ProtoProtonas/SmartBuoy/README.md

# SmartBuoy
Repository for a smart buoy which can navigate to a destination on water and then come back.
