ProtoProtonas/SmartBuoy/Hardware/PCBs/GPSBoard/GPSBoard/GPSBoard_BOM.xlsx

Source: | C:\Users\Augustas\Desktop\shrot\projektukai\ESP32buoy\git\SmartBuoy\Hardware\PCBs\GPSBoard\GPSBoard\GPSBoard.kicad_sch
Date: | 2022-12-19 19:59
Tool: | Eeschema (6.0.9)
Generator: | C:\Program Files\KiCad\6.0\bin\scripting\plugins/bom_csv_grouped_by_value_with_fp.py
Component Count: | 19
Ref | Qnty | Value | Cmp name | Footprint | Description | Vendor
C1 , | 1 | 10u | C | Capacitor_SMD:C_1206_3216Metric_Pad1.33x1.80mm_HandSolder | Unpolarized capacitor | https://eu.mouser.com/ProductDetail/KYOCERA-AVX/1206DD106MAT2A?qs=lhAPX%252BE7qEaaGz%2FHFoBa1A%3D%3D
C2 , | 1 | <12pF | C_Feedthrough | YFF18AC0G475MT0Y0E:YFF18AC | Feedthrough capacitor | https://eu.mouser.com/ProductDetail/TDK/YFF18AC0G475MT0Y0E?qs=DRkmTr78QAR1NERkh6ttFw%3D%3D
D1 , | 1 | ESD9B3.3ST5G | ESD9B3.3ST5G | Diode_SMD:D_SOD-923 | ESD protection diode, 3.3Vrwm, SOD-923 | https://eu.mouser.com/ProductDetail/onsemi/ESD9B3.3ST5G?qs=yU2N9dt%252BrfmXrPf3vhgUEA%3D%3D
D2 ,D3 ,D4 , | 3 | LED | LED | LED_SMD:LED_0603_1608Metric_Pad1.05x0.95mm_HandSolder | Light emitting diode | https://eu.mouser.com/ProductDetail/ROHM-Semiconductor/SML-D12U1WT86?qs=M3jcYzEJUdEySuGkbjHEtQ%3D%3D | https://eu.mouser.com/ProductDetail/Bivar/SM0603UBWC?qs=hWDdE2Pc5RAVU9aZAE1txQ%3D%3D | https://eu.mouser.com/ProductDetail/Lumex/SML-LX0603GW-TR?qs=Ma3pWdXK8s%252BAlupi7PYUJg%3D%3D | https://eu.mouser.com/ProductDetail/Lumex/SML-LXIL0603SYC-TR?qs=gZXFycFWdAMwyS6RHhvOrg%3D%3D
H1 ,H2 ,H3 ,H4 , | 4 | MountingHole_Pad | MountingHole_Pad | MountingHole:MountingHole_2.2mm_M2_Pad_TopBottom | Mounting Hole with connection
IC1 , | 1 | MAX-M10S-00B | MAX-M10S-00B | UBLOX_GPS:MAXM10S00B | GPS Modules u-blox M10 GNSS LCC module, firmware in ROM, SAW filter, LNA | https://eu.mouser.com/ProductDetail/u-blox/MAX-M10S-00B?qs=A6eO%252BMLsxmT0PfQYPb7LLQ%3D%3D
J1 , | 1 | Conn_01x04 | Conn_01x04 | Connector_PinHeader_2.54mm:PinHeader_1x04_P2.54mm_Vertical | Generic connector, single row, 01x04, script generated (kicad-library-utils/schlib/autogen/connector/) | https://eu.mouser.com/ProductDetail/Wurth-Elektronik/61304011121?qs=PhR8RmCirEZJqAFOTF3fMQ%3D%3D
J2 , | 1 | Conn_Coaxial | Conn_Coaxial | Connector_Coaxial:U.FL_Hirose_U.FL-R-SMT-1_Vertical | coaxial connector (BNC, SMA, SMB, SMC, Cinch/RCA, LEMO, ...) | https://eu.mouser.com/ProductDetail/Linx-Technologies/CONUFL001-SMD-T?qs=EU6FO9ffTwfRdkBeQTdJWQ%3D%3D
L1 , | 1 | 100s uH | L | Inductor_SMD:L_1206_3216Metric_Pad1.22x1.90mm_HandSolder | Inductor | https://eu.mouser.com/ProductDetail/Murata-Electronics/LQM31PN4R7M00L?qs=%2F%252BYoplLUB5ijpQp630h8dg%3D%3D
L2 , | 1 | 27nH | L | Inductor_SMD:L_1206_3216Metric_Pad1.22x1.90mm_HandSolder | Inductor | https://eu.mouser.com/ProductDetail/Coilcraft/1206CS-270XGLC?qs=zCSbvcPd3paKUycN%252BNWp2Q%3D%3D | https://eu.mouser.com/ProductDetail/Murata-Electronics/LQW31HN27NK03L?qs=oNdkT8qv77k%2FyX7JWQo3MA%3D%3D
R1 , | 1 | 10 | R | Resistor_SMD:R_1206_3216Metric_Pad1.30x1.75mm_HandSolder | Resistor | https://eu.mouser.com/ProductDetail/Bourns/CRT1206-BY-10R0ELF?qs=h2IHEVivlqAn8l5%2FXyyhmQ%3D%3D
R2 ,R3 ,R4 , | 3 | 55 | R | Resistor_SMD:R_0603_1608Metric_Pad0.98x0.95mm_HandSolder | Resistor | https://eu.mouser.com/ProductDetail/Vishay-Dale/CRCW060356R0FKEB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
 |  |  |  |  |  | https://eu.mouser.com/ProductDetail/Linx-Technologies/ANT-GNCP-C257L160?qs=7D1LtPJG0i0z%2F6%2Fp4pwK%2Fg%3D%3D
