ProtoProtonas/SmartBuoy/Hardware/PCBs/LogicBoard/LogicBoard/bom.xlsx

https://eu.mouser.com/ProductDetail/Espressif-Systems/ESP32-C3-DevKitC-02?qs=stqOd1AaK7%2F1Q62ysr4CMA%3D%3D
https://eu.mouser.com/ProductDetail/Seeed-Studio/101020492
