ProtoProtonas/SmartBuoy/Hardware/PCBs/PowerBoard/PowerBoard/parts_order.xlsx

Ref | Value | Qnty | URL
C1, | 100u | 1 | https://lt.farnell.com/multicomp/mcgpr50v107m8x11/cap-100-f-50v-20/dp/9451412
C2, | 1000u | 1 | https://lt.farnell.com/multicomp/mcgpr50v108m16x26/cap-1000-f-50v-20/dp/9451447
C3, | 10u | 1 | https://lt.farnell.com/multicomp-pro/mctt31f106z100ct/cap-10-f-10v-y5v-1206/dp/1759485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
C4, | 10u | 1 | https://lt.farnell.com/multicomp-pro/mctt31f106z100ct/cap-10-f-10v-y5v-1206/dp/1759485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
D1, | 1N5822 | 1 | https://lt.farnell.com/stmicroelectronics/1n5822/diode-schottky-3a-40v-do-201ad/dp/9801243?st=1n5822
D2, D3, D4 | LED | 3 | https://lt.farnell.com/multicomp/mcl053gd/led-5mm-36-green/dp/1581138
H1, H2, H3, H4, | MountingHole_Pad | 4
J1, J3, J5, | Screw_Terminal_01x02 | 3 | https://lt.farnell.com/multicomp/mc000034/terminal-block-wire-to-brd-2pos/dp/2008004?st=screw%20terminal
J2, | Conn_01x04 | 1 | https://lt.farnell.com/multicomp/spc20484/header-1row-40way/dp/1462888
J4, J6, | Conn_01x02 | 2 | https://lt.farnell.com/multicomp/spc20484/header-1row-40way/dp/1462888
L1, | 100u | 1 | https://lt.farnell.com/coilcraft/1812ps-104klb/inductor-100uh-0-65a-10-pwr-14mhz/dp/2287104
R1, | 500 | 1 | https://lt.farnell.com/yageo/rc0603jr-07470rl/res-470r-5-0-1w-0603-thick-film/dp/9233334
R3, | 150 | 1 | https://lt.farnell.com/multicomp/mcwr08x1500ftl/res-150r-1-0-125w-0805-thick-film/dp/2447574
R4, | 55 | 1 | https://lt.farnell.com/yageo/rc0603fr-0756rl/res-56r-1-0-1w-0603-thick-film/dp/9238336
U1, | L298HN | 1 | https://lt.farnell.com/stmicroelectronics/l298n/ic-bridge-driver-dual-298/dp/403295?st=l298
U2, | LM2576HVS-5 | 1 | https://lt.farnell.com/texas-instruments/lm2576s-5-0-nopb/ic-dc-dc-converter-3a/dp/3008144
U3, | NCP1117-3.3_SOT223 | 1 | https://lt.farnell.com/on-semiconductor/ncp1117st33t3g/ic-linear-voltage-regulator/dp/1652366
