ProtoProtonas/SmartBuoy/Hardware/PCBs/GPSBoard/GPSBoard/Footprints/LIB_MAX-M10S-00B/MAX-M10S-00B/3D/MAX-M10S-00B.stp

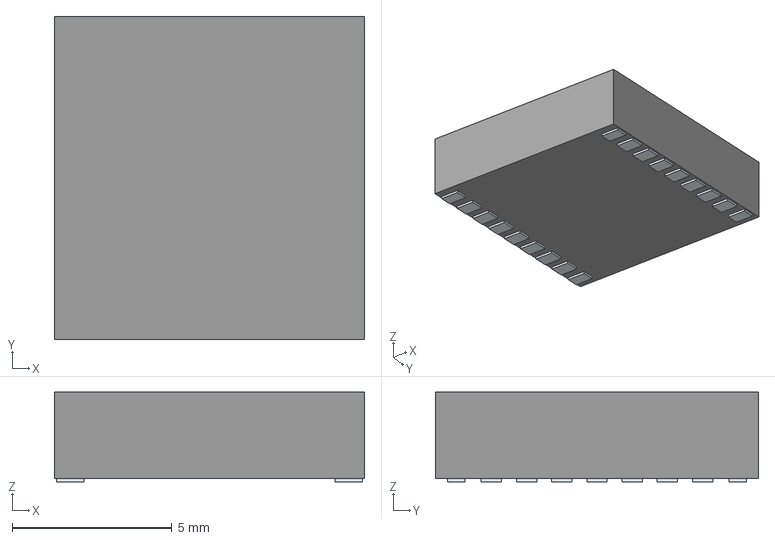
[picture p1: CAD file, 2022-07-05]
Hardware/PCBs/GPSBoard/GPSBoard/Footprints/LIB_MAX-M10S-00B/MAX-M10S-00B/3D/MAX-M10S-00B.stp
9.70 x 10.1 x 2.80 mm
Pins
