ProtoProtonas/SmartBuoy/Hardware/PCBs/GPSBoard/GPSBoard/Footprints/LIB_YFF15PC1A224MT000N/YFF15PC1A224MT000N/3D/YFF15PC1A224MT000N.stp

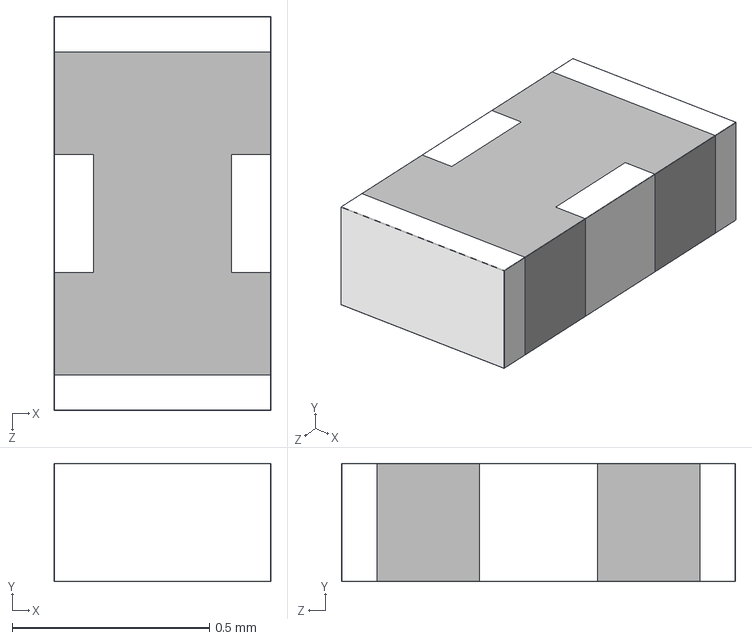
[picture p2: CAD file, 2022-12-25]
Hardware/PCBs/GPSBoard/GPSBoard/Footprints/LIB_YFF15PC1A224MT000N/YFF15PC1A224MT000N/3D/YFF15PC1A224MT000N.stp
0.55 x 0.3 x 1.00 mm
