ProtoProtonas/SmartBuoy/(list of files, cad)

Other CAD files:
Hardware/PCBs/GPSBoard/GPSBoard/Footprints/MAX-M10S-00B.stl
Hardware/PCBs/GPSBoard/GPSBoard/Footprints/LIB_MAX-M10S-00B/MAX-M10S-00B/Allegro/maxm10s00b.psm
Hardware/PCBs/GPSBoard/GPSBoard/Footprints/LIB_MAX-M10S-00B/MAX-M10S-00B/DEHDL/max_m10s_00b/chips/chips.prt
Hardware/PCBs/GPSBoard/GPSBoard/Footprints/LIB_YFF15PC1A224MT000N/YFF15PC1A224MT000N/Allegro/yff15pc.psm
Hardware/PCBs/GPSBoard/GPSBoard/Footprints/LIB_YFF15PC1A224MT000N/YFF15PC1A224MT000N/DEHDL/yff15pc1a224mt000n/chips/chips.prt
