ProtoProtonas/SmartBuoy/(list of files, drawings)

Other design files:
Hardware/PCBs/GPSBoard/GPSBoard/Footprints/LIB_YFF15PC1A224MT000N/YFF15PC1A224MT000N/Altium/YFF15PC1A224MT000N.SchLib
Hardware/PCBs/GPSBoard/GPSBoard/Footprints/LIB_YFF15PC1A224MT000N/YFF15PC1A224MT000N/Altium/YFF15PC.PcbLib
