ProtoProtonas/SmartBuoy/Hardware/PCBs/LogicBoard/LogicBoard/LogicBoard.kicad_pcb

## KiCad design Hardware/PCBs/LogicBoard/LogicBoard/LogicBoard.kicad_pcb (2023-01-01)

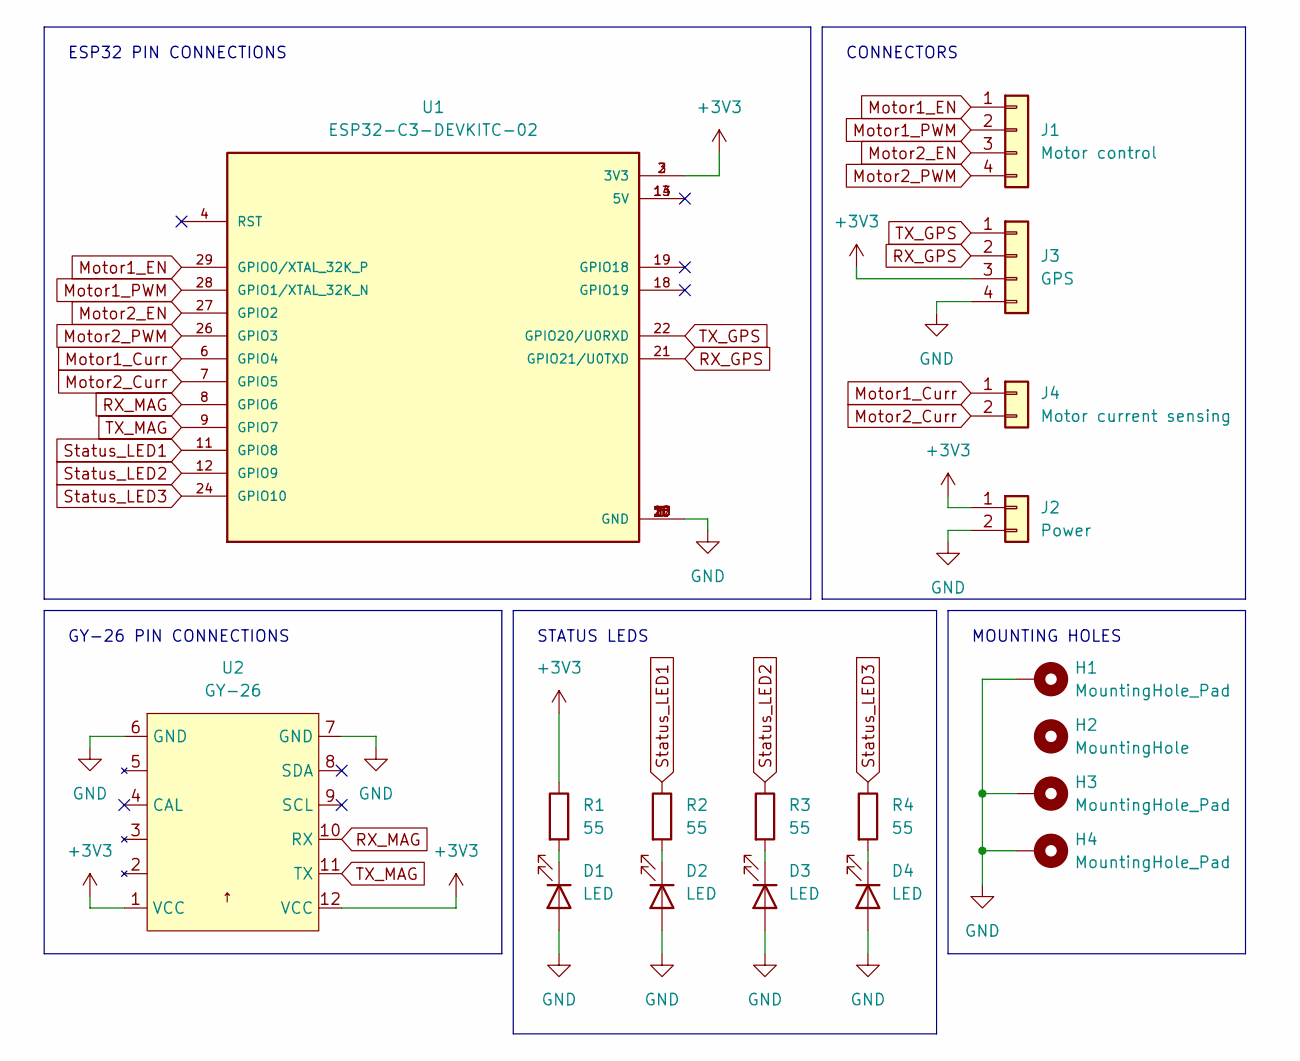
[picture p3: schematic LogicBoard.kicad_sch]

Parts:
D1, D2, D3, D4: LED; LED_0603_1608Metric_Pad1.05x0.95mm_HandSolder
H1: MountingHole_Pad; MountingHole_2.2mm_M2_DIN965_Pad_TopBottom
H2: MountingHole; MountingHole_2.2mm_M2_DIN965
H3, H4: MountingHole_Pad; MountingHole_2.2mm_M2_ISO7380_Pad_TopBottom
J1: Motor control; PinHeader_1x04_P2.54mm_Vertical
J2: Power; PinHeader_1x02_P2.54mm_Vertical
J3: GPS; PinHeader_1x04_P2.54mm_Vertical
J4: Motor current sensing; PinHeader_1x02_P2.54mm_Vertical
R1, R2, R3, R4: 55; R_0603_1608Metric_Pad0.98x0.95mm_HandSolder
U1: ESP32-C3-DEVKITC-02; XCVR_ESP32-C3-DEVKITC-02
U2: GY-26

Connections:
+3V3: J2.1, J3.3, R1.1, U1.2 (3V3), U1.3 (3V3), U2.1 (VCC), U2.12 (VCC)
GND: D1.2 (A), D2.2 (A), D3.2 (A), D4.2 (A), H1.1, H3.1, H4.1, J2.2, J3.4, U1.1 (GND), U1.5 (GND), U1.10 (GND), U1.15 (GND), U1.16 (GND), U1.17 (GND), U1.20 (GND), U1.23 (GND), U1.25 (GND), U1.30 (GND), U2.6 (GND), U2.7 (GND)
Motor1_Curr: J4.1, U1.6 (GPIO4)
Motor1_EN: J1.1, U1.29 (GPIO0/XTAL_32K_P)
Motor1_PWM: J1.2, U1.28 (GPIO1/XTAL_32K_N)
Motor2_Curr: J4.2, U1.7 (GPIO5)
Motor2_EN: J1.3, U1.27 (GPIO2)
Motor2_PWM: J1.4, U1.26 (GPIO3)
unnamed: D1.1 (K), R1.2
unnamed: D2.1 (K), R2.2
unnamed: D3.1 (K), R3.2
unnamed: D4.1 (K), R4.2
RX_GPS: J3.2, U1.21 (GPIO21/U0TXD)
RX_MAG: U1.8 (GPIO6), U2.10 (RX)
Status_LED1: R2.1, U1.11 (GPIO8)
Status_LED2: R3.1, U1.12 (GPIO9)
Status_LED3: R4.1, U1.24 (GPIO10)
TX_GPS: J3.1, U1.22 (GPIO20/U0RXD)
TX_MAG: U1.9 (GPIO7), U2.11 (TX)

Notes on the sheet:
MOUNTING HOLES
CONNECTORS
GY-26 PIN CONNECTIONS
STATUS LEDS
ESP32 PIN CONNECTIONS

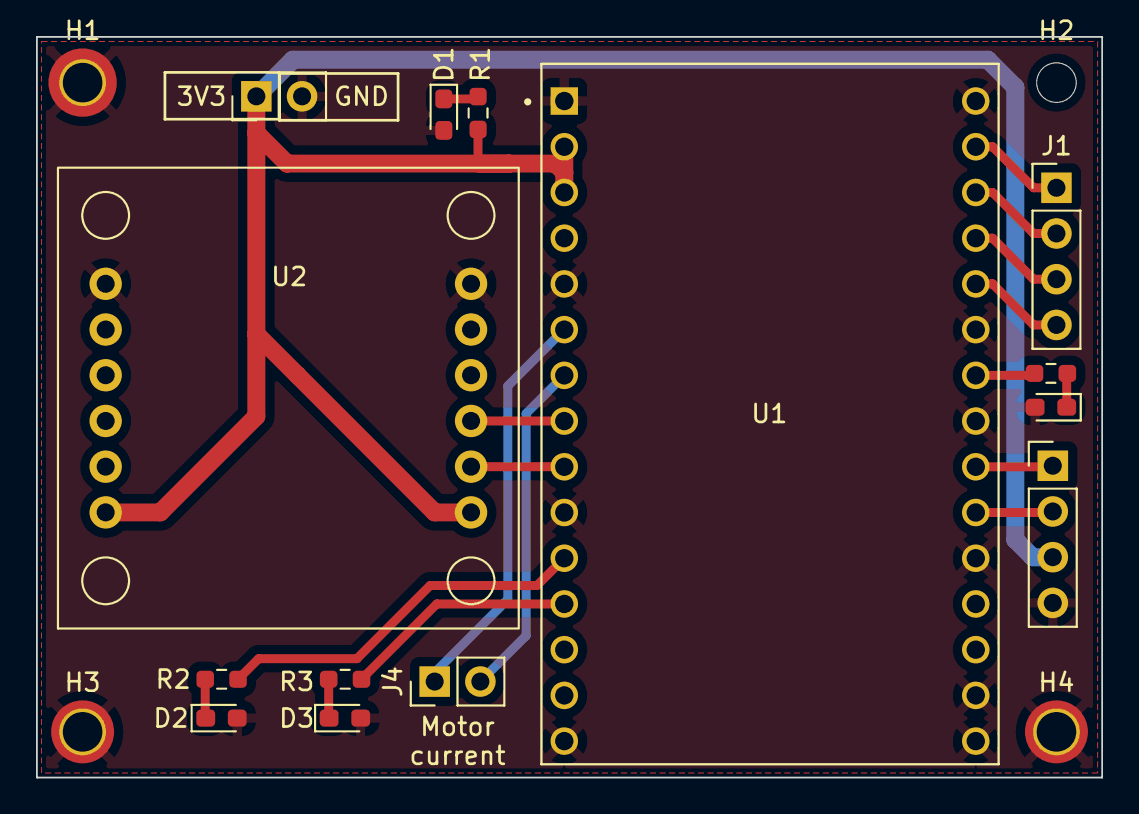
[picture p4: board LogicBoard.kicad_pcb from above]

Board: 2 copper layers, 59.2 x 41.1 mm, 18 parts (0 on the bottom side), 19 nets.
