ProtoProtonas/SmartBuoy/Hardware/PCBs/GPSBoard/GPSBoard/GPSBoard.kicad_pcb

## KiCad design Hardware/PCBs/GPSBoard/GPSBoard/GPSBoard.kicad_pcb (2022-12-25)

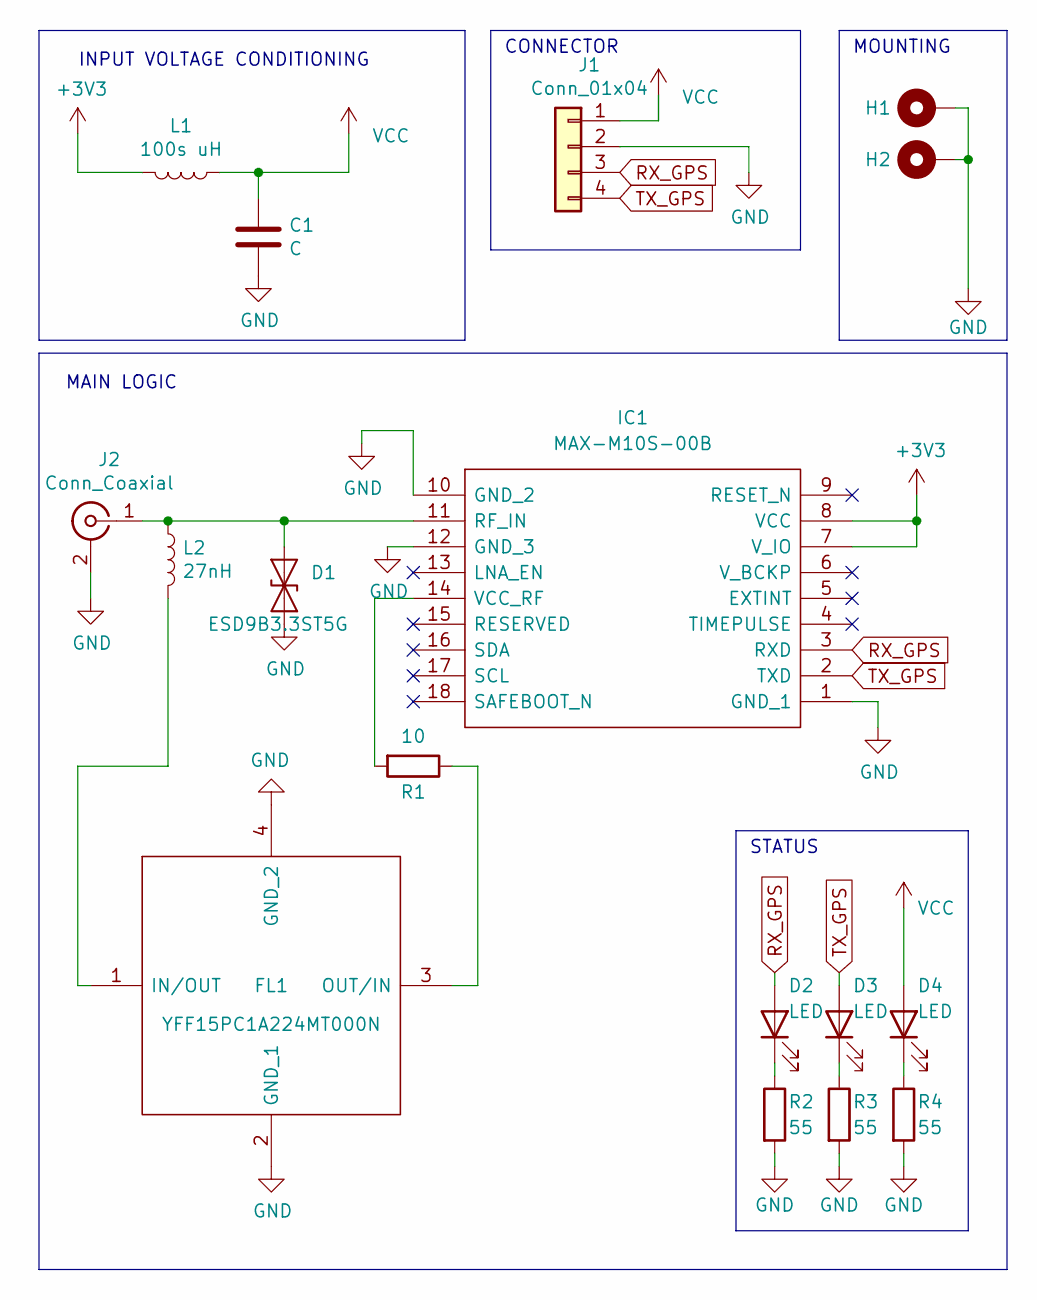
[picture p5: schematic GPSBoard.kicad_sch]

Parts:
C1: C; C_1206_3216Metric_Pad1.33x1.80mm_HandSolder
D1: ESD9B3.3ST5G; D_SOD-923
D2, D3, D4: LED; LED_0603_1608Metric_Pad1.05x0.95mm_HandSolder
FL1: YFF15PC1A224MT000N; YFF15PC; Mouser Part Number 810-YFF15PC1A224M
H1, H2: MountingHole_Pad; MountingHole_2.2mm_M2_Pad_TopBottom
IC1: MAX-M10S-00B; MAXM10S00B; Mouser Part Number 377-MAX-M10S-00B
J1: Conn_01x04; PinHeader_1x04_P2.54mm_Vertical
J2: Conn_Coaxial; U.FL_Molex_MCRF_73412-0110_Vertical
L1: 100s uH; L_1206_3216Metric_Pad1.22x1.90mm_HandSolder
L2: 27nH; L_1206_3216Metric_Pad1.22x1.90mm_HandSolder
R1: 10; R_1206_3216Metric_Pad1.30x1.75mm_HandSolder
R2, R3, R4: 55; R_0603_1608Metric_Pad0.98x0.95mm_HandSolder

Connections:
+3V3: IC1.7 (V_IO), IC1.8 (VCC), L1.2
GND: C1.2, D1.1 (A1), FL1.2 (GND_1), FL1.4 (GND_2), H1.1, H2.1, IC1.1 (GND_1), IC1.10 (GND_2), IC1.12 (GND_3), J1.2, J2.2 (Ext), R2.2, R3.2, R4.2
unnamed: D1.2 (A2), IC1.11 (RF_IN), J2.1 (In), L2.1
unnamed: D2.1 (K), R2.1
unnamed: D3.1 (K), R3.1
unnamed: D4.1 (K), R4.1
unnamed: FL1.1 (IN/OUT), L2.2
unnamed: FL1.3 (OUT/IN), R1.1
unnamed: IC1.14 (VCC_RF), R1.2
RX_GPS: D2.2 (A), IC1.3 (RXD), J1.3
TX_GPS: D3.2 (A), IC1.2 (TXD), J1.4
VCC: C1.1, D4.2 (A), J1.1, L1.1

Notes on the sheet:
CONNECTOR
STATUS
MOUNTING
INPUT VOLTAGE CONDITIONING
MAIN LOGIC

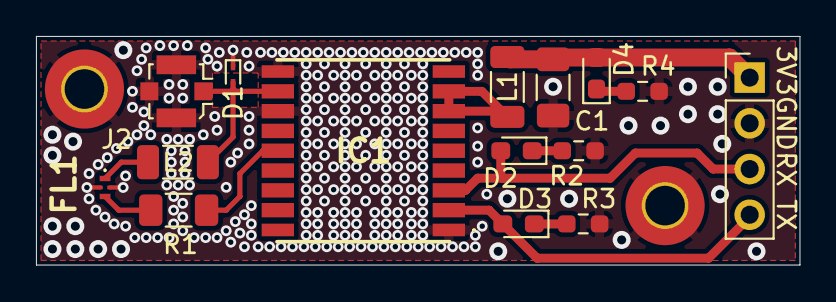
[picture p6: board GPSBoard.kicad_pcb from above]

Board: 2 copper layers, 42.4 x 12.7 mm, 17 parts (0 on the bottom side), 12 nets.
