ProtoProtonas/SmartBuoy/Hardware/PCBs/PowerBoard/PowerBoard/PowerBoard.kicad_pcb

## KiCad design Hardware/PCBs/PowerBoard/PowerBoard/PowerBoard.kicad_pcb (2022-11-22)

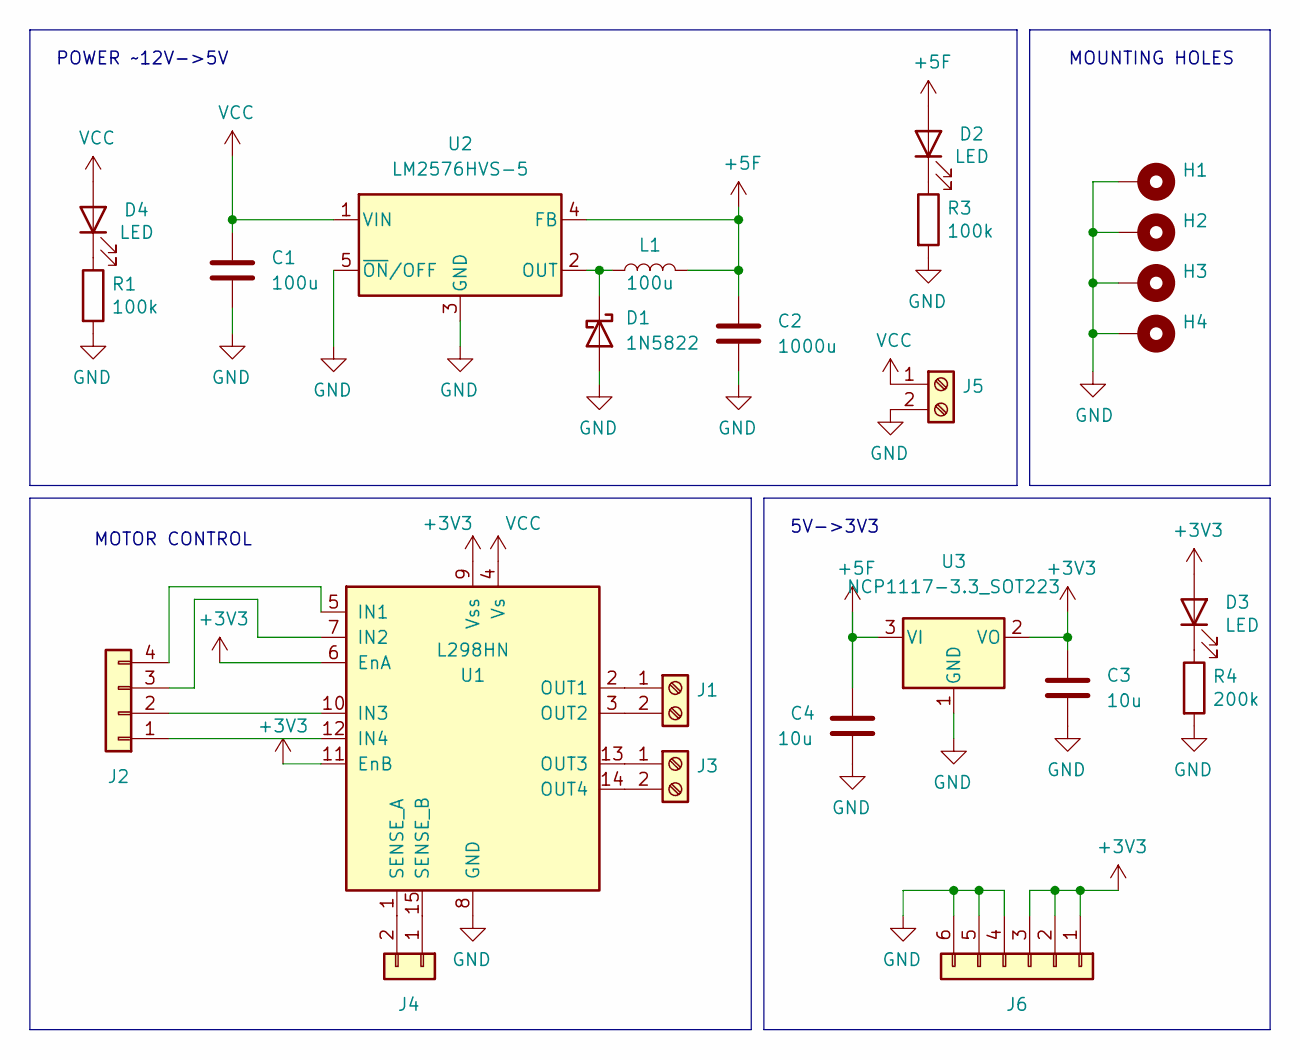
[picture p7: schematic PowerBoard.kicad_sch]

Parts:
C1: 100u; CP_Radial_D8.0mm_P3.50mm
C2: 1000u; CP_Radial_D16.0mm_P7.50mm
C3, C4: 10u; C_1206_3216Metric_Pad1.33x1.80mm_HandSolder
D1: 1N5822; D_DO-201AD_P15.24mm_Horizontal
D2, D3, D4: LED; LED_D5.0mm
H1, H2, H3, H4: MountingHole_Pad; MountingHole_3.2mm_M3_DIN965_Pad_TopBottom
J1, J3, J5: Screw_Terminal_01x02; TerminalBlock_bornier-2_P5.08mm
J2: Conn_01x04; PinSocket_1x04_P2.54mm_Vertical
J4: Conn_01x02; PinSocket_1x02_P2.54mm_Vertical
J6: Conn_01x06; PinSocket_1x06_P2.54mm_Vertical
L1: 100u; L_1812_4532Metric_Pad1.30x3.40mm_HandSolder
R1: 100k; R_0603_1608Metric_Pad0.98x0.95mm_HandSolder
R3: 100k; R_0805_2012Metric_Pad1.20x1.40mm_HandSolder
R4: 200k; R_0603_1608Metric_Pad0.98x0.95mm_HandSolder
U1: L298HN; TO-220-15_P2.54x2.54mm_StaggerOdd_Lead4.58mm_Vertical
U2: LM2576HVS-5; TO-263-5_TabPin3
U3: NCP1117-3.3_SOT223; SOT-223-3_TabPin2

Connections:
+3V3: C3.1, D3.2 (A), J6.1, J6.2, J6.3, U1.6 (EnA), U1.9 (Vss), U1.11 (EnB), U3.2 (VO)
+5F: C2.1, C4.1, D2.2 (A), L1.2, U2.4 (FB), U3.3 (VI)
GND: C1.2, C2.2, C3.2, C4.2, D1.2 (A), H1.1, H2.1, H3.1, H4.1, J5.2, J6.4, J6.5, J6.6, R1.2, R3.2, R4.2, U1.8 (GND), U2.3 (GND), U2.5 (~ON/OFF), U3.1 (GND)
unnamed: D1.1 (K), L1.1, U2.2 (OUT)
unnamed: D2.1 (K), R3.1
unnamed: D3.1 (K), R4.1
unnamed: D4.1 (K), R1.1
unnamed: J1.1, U1.2 (OUT1)
unnamed: J1.2, U1.3 (OUT2)
unnamed: J2.1, U1.12 (IN4)
unnamed: J2.2, U1.10 (IN3)
unnamed: J2.3, U1.7 (IN2)
unnamed: J2.4, U1.5 (IN1)
unnamed: J3.1, U1.13 (OUT3)
unnamed: J3.2, U1.14 (OUT4)
unnamed: J4.1, U1.15 (SENSE_B)
unnamed: J4.2, U1.1 (SENSE_A)
VCC: C1.1, D4.2 (A), J5.1, U1.4 (Vs), U2.1 (VIN)

Notes on the sheet:
POWER ~12V->5V
MOTOR CONTROL
MOUNTING HOLES
5V->3V3

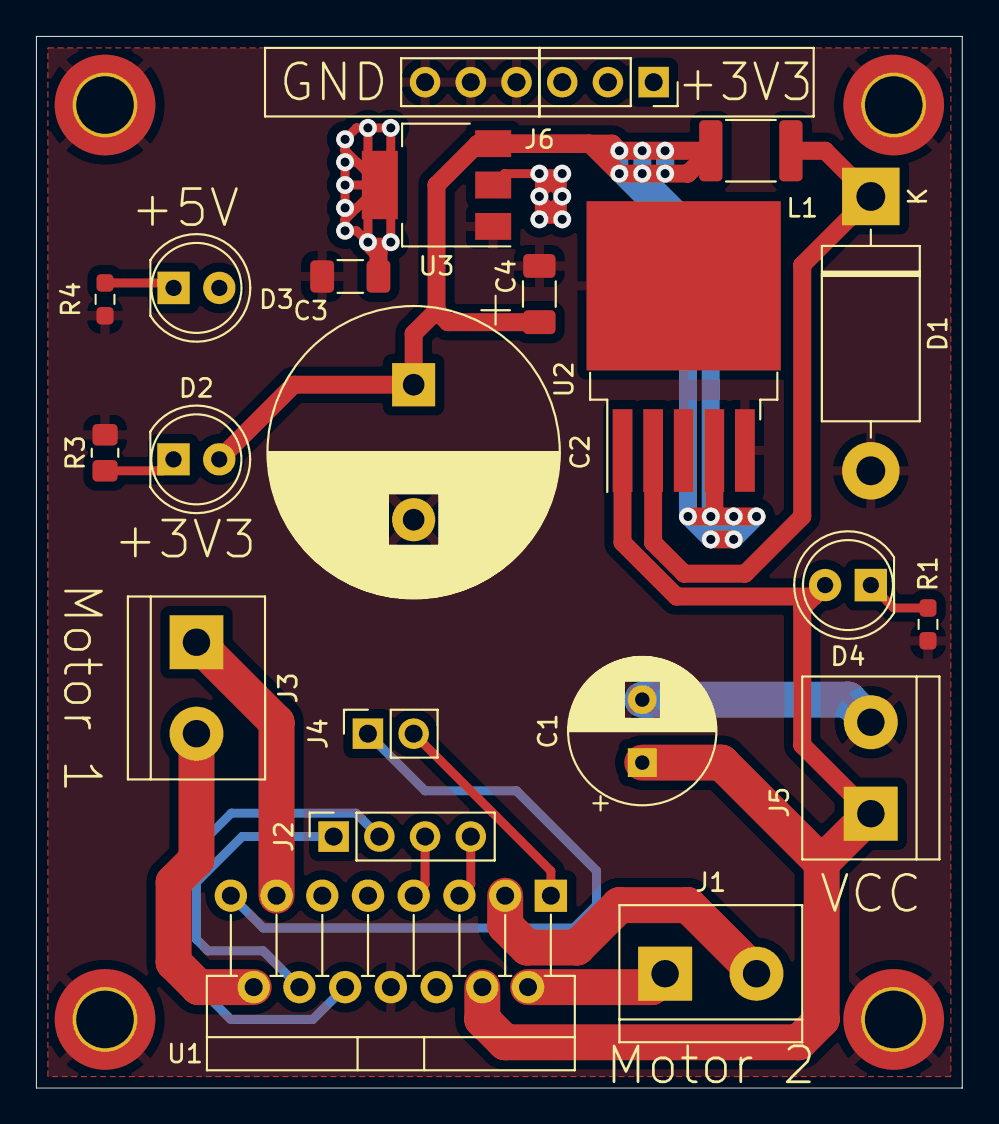
[picture p8: board PowerBoard.kicad_pcb from above]

Board: 2 copper layers, 51.4 x 58.4 mm, 25 parts (0 on the bottom side), 18 nets.
