ProtoProtonas/SmartBuoy/(commit log)

2022-03-12 Added motor control wrapper
2022-03-26 Added comments where device needs to be calibrated
2022-04-16 Target destination switching based on time elapsed
2022-04-17 Averager template added for GPS and compass sensors
2022-04-17 PCB + more folders added
    [PowerBoard.kicad_pcb, PowerBoard.sch]
2022-04-19 Finished power schematic and L298 wiring
    [PowerBoard.sch]
2022-04-20 PCB component footprints added
    [PowerBoard.kicad_pcb, PowerBoard.sch]
2022-04-22 PCB routed
    [PowerBoard.kicad_pcb, PowerBoard.sch]
2022-05-17 Added ground planes and mounting holes
    [PowerBoard.kicad_pcb]
2022-06-25 Added third mounting hole
    [PowerBoard.kicad_pcb, PowerBoard.sch]
2022-07-05 Created projects for logic and GPS boards, started working on GPS
    [GPSBoard.kicad_pcb, GPSBoard.sch, LogicBoard.kicad_pcb, LogicBoard.sch, MAX-M10S-00B.stl, MAX-M10S-00B.stp]
2022-07-06 GPS board schematic created
    [GPSBoard.sch]
2022-07-10 GPS PCB designed
    [GPSBoard.sch]
2022-11-22 Rewamped power board
    [GPSBoard.csv, GPSBoard.kicad_sch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]
2022-12-25 Designed GPS board
    [EDI2CAP.CFG, GPSBoard - Copy.csv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]
2023-01-01 Added silkscreen
    [LogicBoard.kicad_pcb, LogicBoard.kicad_sch]
2023-01-01 Added BOM
    [LogicBoard.csv, LogicBoard.xlsx]
